jcfont180-source/robotic-gripper/cad/Gripper_assembly.SLDASM

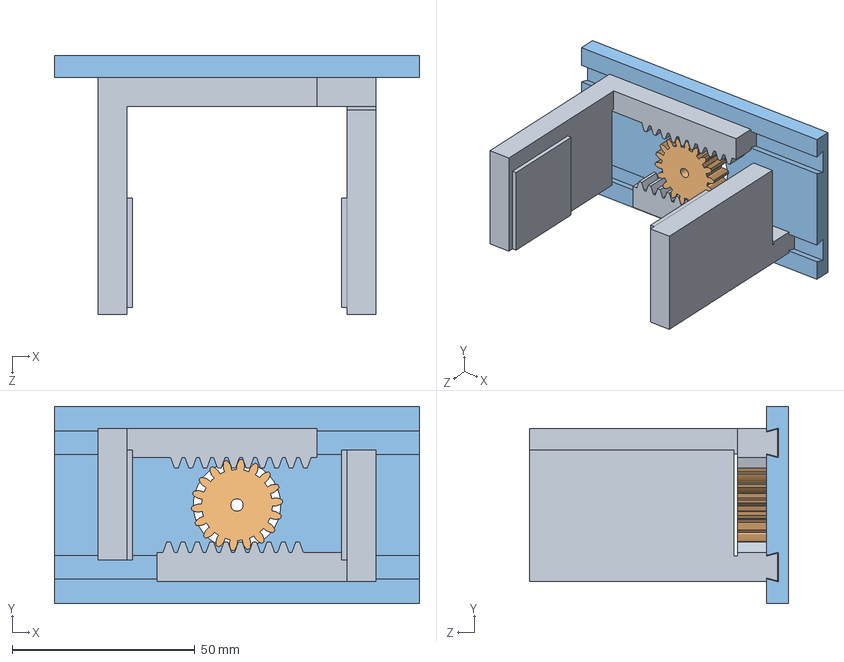
[picture p3: CAD file, 2026-10-20]
cad/Gripper_assembly.SLDASM
100.0 x 54.0 x 71.0 mm
base_plate
Pinion
Finger_Rack x 2
