jcfont180-source/robotic-gripper/cad/profiles/finger_rack_profile.dxf

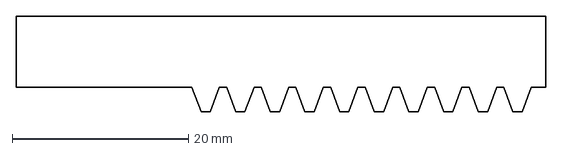
[picture p4: CAD file, 2026-10-19]
cad/profiles/finger_rack_profile.dxf
60.0 x 10.8 mm
