jcfont180-source/robotic-gripper/cad/base_plate.SLDPRT

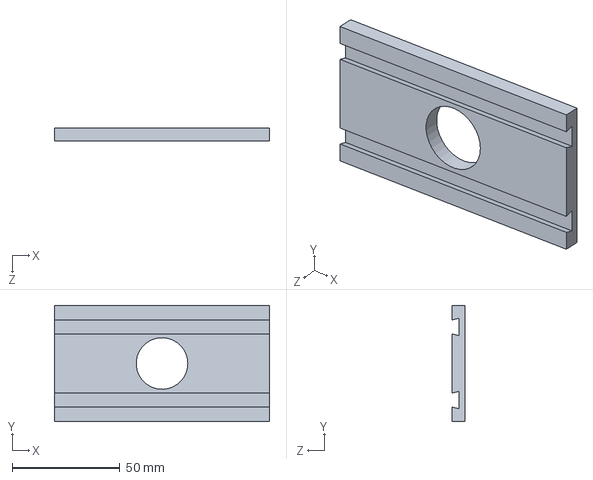
[picture p5: CAD file, 2026-10-19]
cad/base_plate.SLDPRT
100.0 x 54.0 x 6.00 mm
