jcfont180-source/robotic-gripper/cad/profiles/pinion_m1.25_z18.dxf

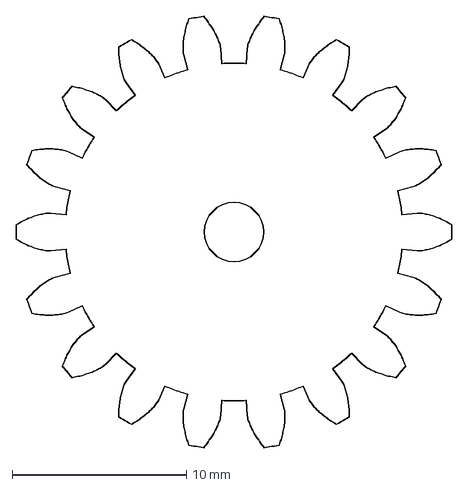
[picture p6: CAD file, 2026-10-19]
cad/profiles/pinion_m1.25_z18.dxf
25.0 x 24.8 mm
