jcfont180-source/robotic-gripper/cad/Finger_Rack.SLDPRT

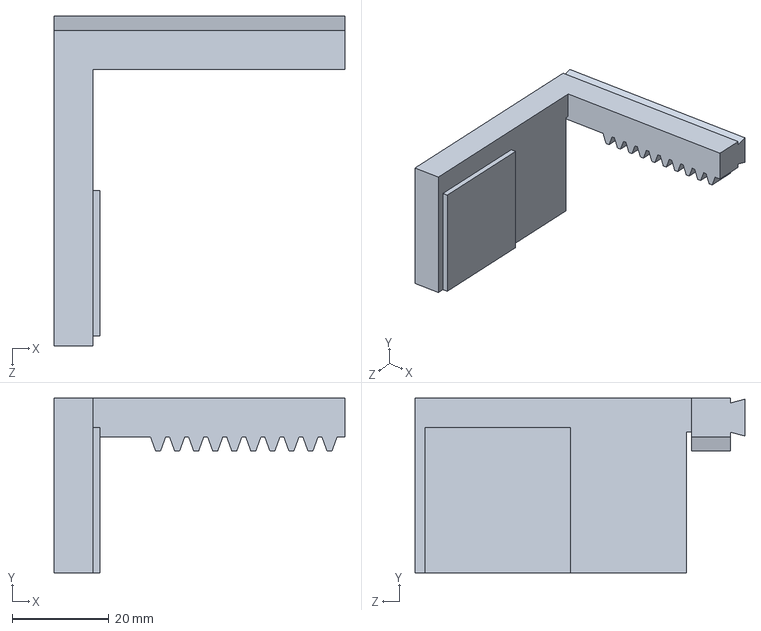
[picture p7: CAD file, 2026-10-19]
cad/Finger_Rack.SLDPRT
60.0 x 36.0 x 68.0 mm
