jcfont180-source/robotic-gripper/cad/Pinion.SLDPRT

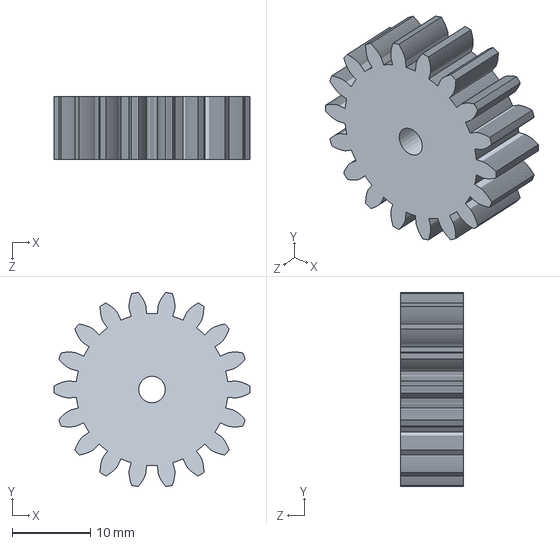
[picture p8: CAD file, 2026-10-19]
cad/Pinion.SLDPRT
25.0 x 24.8 x 8.00 mm
