jcfont180-source/robotic-gripper/(commit log)

2026-10-18 Add spec, measurement data, and analysis templates
    [egg_sample.csv, test_objects.csv]
2026-10-18 Size pinion and jaw kinematics
2026-10-19 Add core CAD parts and involute profile scripts
    [Finger_Rack.SLDPRT, Pinion.SLDPRT, base_plate.SLDPRT, finger_rack_profile.dxf, pinion_m1.25_z18.dxf]
2026-10-19 Size servo torque and choose MG996R
2026-10-19 Document CAD dimensions used by the profile scripts
2026-10-19 Rebuild assembly with datum mates; fix finger-rack arm side
    [Finger_Rack.SLDPRT, Gripper_assembly.SLDASM, base_plate.SLDPRT]
2026-10-19 Add rack-pinion mates: gear drives both fingers
    [Gripper_assembly.SLDASM]
2026-10-20 Interference check clean at 37/63.2/78 mm; re-time rack-pinion mates
    [Gripper_assembly.SLDASM]
2026-10-20 Add motion study; log travel limits and animation
    [Gripper_assembly.SLDASM]
